maxpower-ar/zeus/img/lm393.jpeg

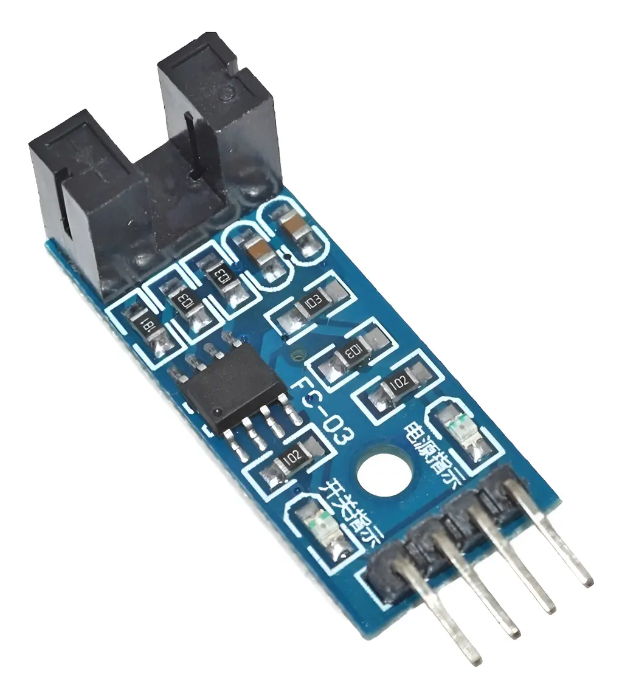
img/lm393.jpeg
