maxpower-ar/zeus/img/esp32.jpeg

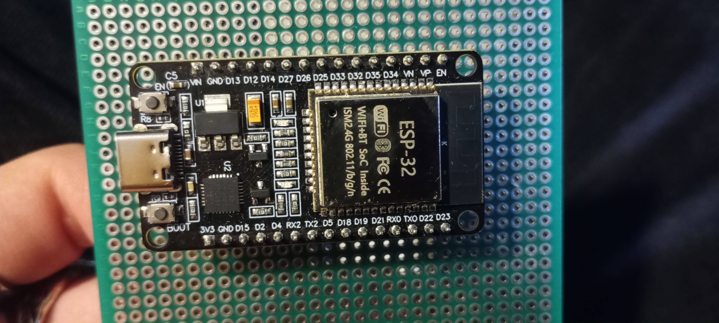
img/esp32.jpeg
