maxpower-ar/zeus/img/cooler_JF0825B1HS-R.jpeg

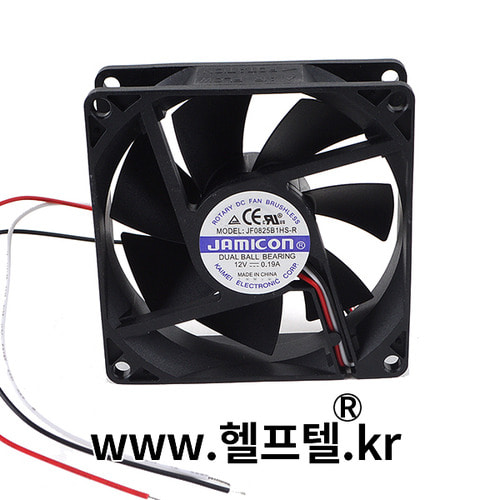
img/cooler_JF0825B1HS-R.jpeg
