maxpower-ar/zeus/img/hall.jpeg

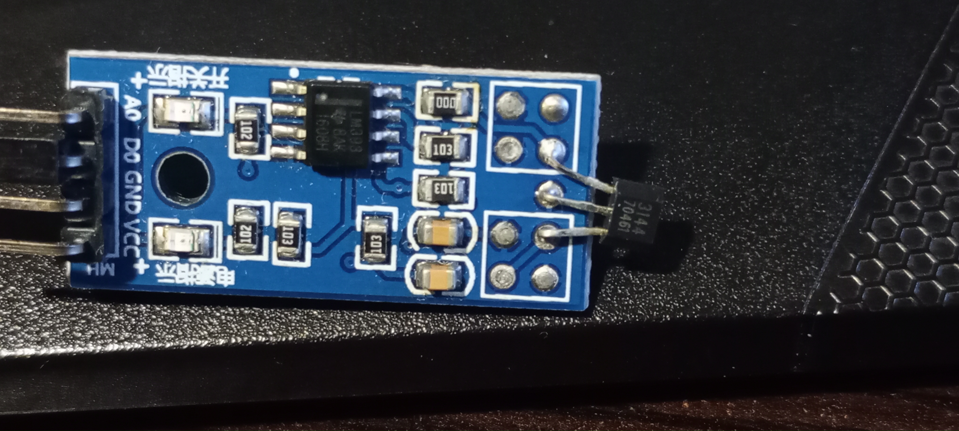
img/hall.jpeg
