maxpower-ar/zeus/(commit log)

2026-09-05 Estructura inicial del proyecto y plan de fases
    Estación meteorológica de dos nodos ESP32: uno de campo que registra y
    almacena, otro de interfaz que hace de puente USB hacia la PC.
    Incluye:
    - CLAUDE.md con las reglas de trabajo y las restricciones de hardware
    - Plan dividido en fases 0-9 (núcleo) y A-E (opcionales)
    - Documentación de pinout, sensores, protocolo y formato de datos
    - Lista de componentes disponibles y por comprar
    Decisiones de diseño:
    - Arduino IDE con el repositorio como sketchbook, para compartir código
    entre ambos sketches sin duplicarlo
    - ESP-NOW detrás de una interfaz de transporte reemplazable
    - LittleFS para el log; microSD y deep-sleep quedan como fases opc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
2026-09-05 Anemómetro: pasar de motor DC a encoder óptico ranurado
    El motor DC funciona como dinamo y su relación tensión-velocidad es
    lineal, pero la fricción de las escobillas impone un umbral de arranque
    de 8 a 15 km/h. Por debajo de eso informa cero, indistinguible de la
    calma, y ese es justamente el rango de viento más frecuente.
    El encoder óptico ranurado de los kits de motor TT ya estaba disponible,
    no toca el eje (fricción nula) y entrega unos 20 pulsos por vuelta en
    lugar de 1 o 2, con resolución suficiente a viento suave.
    Riesgos anotados:
    - El sol emite infrarrojo y puede cegar el sensor: carcasa opaca
    obligatoria y prueba al sol del mediodía antes de darlo por bueno
    - No puede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
2026-09-06 Evaluar el cooler brushless como rotor y eje del anemómetro
    El cooler Jamicon de 80 mm no compite con el FC-03, que sigue siendo el
    sensor: compite con el rotor y el eje que había que fabricar.
    No sirve como generador. En un brushless las bobinas están en el estator
    y un integrado las conmuta; ese integrado queda entre las bobinas y los
    cables, así que la tensión generada no sale. La salida de tacómetro de
    los modelos de tres cables tampoco ayuda: depende del Hall interno, que
    solo funciona con el ventilador alimentado, y alimentado gira solo.
    Lo que aporta es el doble rodamiento a bolillas, que es lo que fija el
    umbral de arranque del instrumento.
    Riesgo anotado: un brushless sin a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
2026-09-07 Fase 1: DHT22 verificado en banco y LM35 descartados
    Firmware:
    - estacion_campo y estacion_interfaz con el sketch de fase 0 (parpadeo del LED
    y MAC por serie), con parpadeos invertidos para distinguir las dos placas
    - estacion_campo suma la lectura de sensores en sensores.h/.cpp, donde cada
    funcion informa ademas si el dato es valido
    - prueba_dht22 y prueba_lm35: sketches minimos de banco, fuera del firmware
    Resultado de las pruebas:
    - DHT22 verificado: estable en reposo, llega a 98 % HR soplando y sube a 26.7 C
    apoyado contra una pava caliente. Queda como sensor de temperatura del proyecto
    - Los dos LM35Z no funcionan: con 4.8 V verificados y orientacion correcta entregan
    10-30 m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
    [config.h, estacion_campo.ino, estacion_interfaz.ino, sensores.cpp, sensores.h]
2026-09-07 Agrupar los sketches de prueba en pruebas/
    Los sketches de banco estaban en la raiz del repositorio, mezclados con los dos
    firmwares y con un nombre por sensor. Pasan a pruebas/, un sketch por sensor:
    prueba_dht22/prueba_dht22.ino -> pruebas/dht22/dht22.ino
    prueba_lm35/prueba_lm35.ino -> pruebas/lm35/lm35.ino
    El Arduino IDE muestra las carpetas anidadas como submenu, asi que siguen
    abriendose desde Archivo -> Sketchbook -> pruebas.
    Documentada la carpeta en README y CLAUDE.md, para dejar explicito que son
    pruebas de concepto y no producto. Corregidas las rutas en la bitacora.
2026-10-14 Anemómetro: velocidad del viento en m/s y km/h, disco de 30 ranuras
    Nuevo sketch pruebas/anemometro: imprime m/s y km/h además de vueltas
    por minuto, con modo de calibración por teclado (c <km/h>) para medir la
    constante contra una referencia conocida sin recompilar.
    Una sola constante de calibración. El radio del rotor y el factor del
    anemómetro (las cazoletas giran 2.5 a 3 veces más lento que el viento)
    no se miden por separado: no hace falta y no se puede con precisión. Se
    mide su producto, metrosPorPulso, de una sola vez.
    La conversión m/s a km/h es x3.6 exacto y no es una calibración: si una
    está mal, la otra está igual de mal. Se imprimen las dos por comodidad.
    Los dos sk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
2026-10-14 Disco del encoder: 30 ranuras confirmadas, geometría al repositorio
    El modelo OpenSCAD vigente del disco tiene enc_ranuras = 30. El
    enc_ranuras = 20 que generaba la contradicción correspondía al disco
    viejo de 36 mm, obsoleto: con ese diámetro no entran 30 ranuras, el
    diente quedaba en medio milímetro, más angosto que la ranura óptica
    del FC-03.
    El .scad del disco pasa a hardware/modelos/encoder_disco.scad y queda
    como fuente de verdad de ese número. Antes la geometría vivía solo en
    la carpeta de impresión, fuera del repositorio, y el firmware no tenía
    contra qué verificarse.
    Verificado por cálculo: las ranuras trapezoidales mantienen un ciclo de
    trabajo de 48.8% a 49.9% en t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
2026-10-19 Compilación verificada y sin advertencias en los tres sketches del encoder
    Compilados con arduino-cli contra esp32:esp32:esp32, core 3.3.10, con
    --warnings all. Los tres entran en el 22% de la flash y el 6% de la RAM.
    Se reemplazan los incrementos sobre variables volatile por asignación
    explícita: en C++20 el operador ++ sobre un tipo volatile está
    deprecado y el compilador lo advertía en las tres rutinas de
    interrupción. El comportamiento no cambia.
